roopaksai543/Habit-Tracker-Box/media/HabitTrackerBoxSchematicV1.pdf

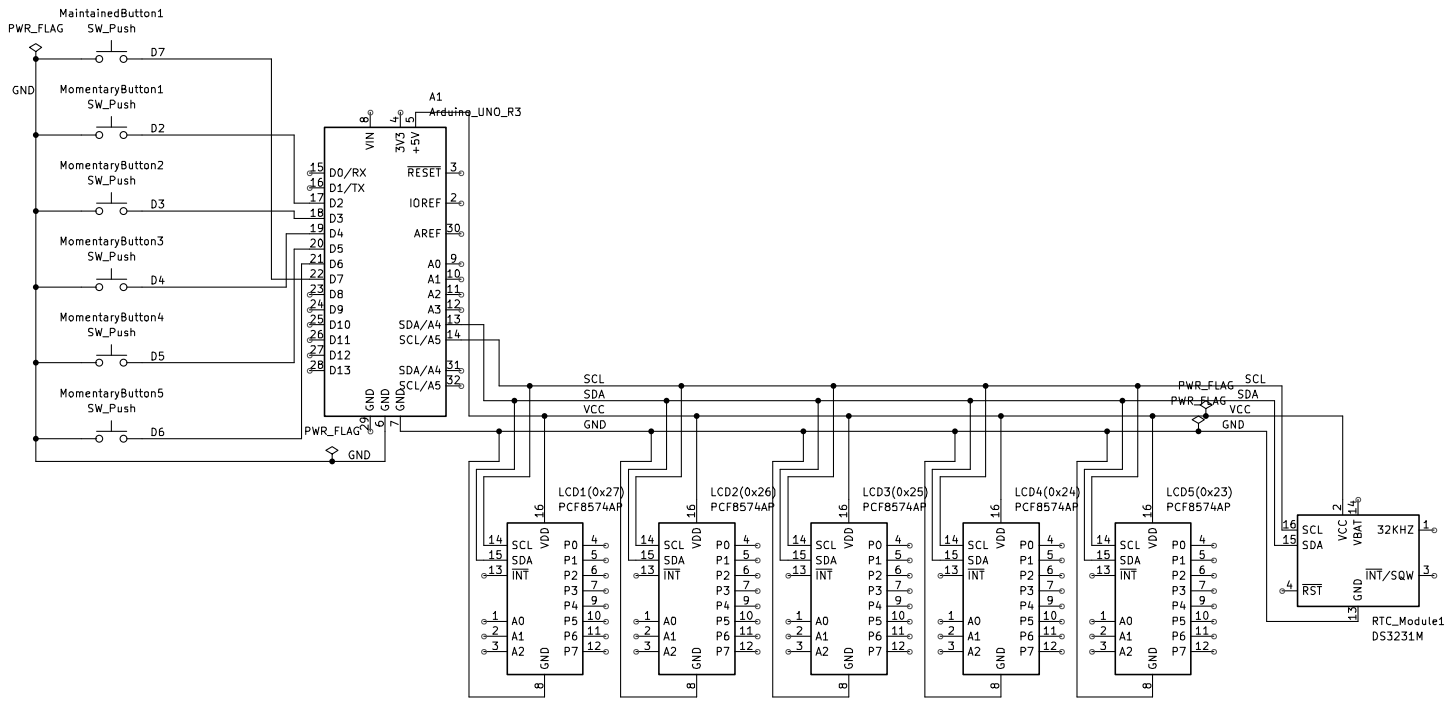
[picture p5: page 1]
